ut-robotics/picr22-team-placeholder/(threads)

Thread 10 (2022-10-29):

DRV8243 current limiting

ReikoR, 2022-10-29:
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

To prevent motors from overheating, it is recommended to configure driver output current limit to around 2 - 3A.

When ITRIP is connected to GND the current regulation is disabled.

From datasheet:
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

ITRIP should be configured to some level (leaving the pin unconnected sets ITRIP level to 2.97V) and IPROPI resistor should be connected to set a current limit.

Closed 2022-11-06.

Thread 13 (2022-10-29):

Power solder pads pin naming

ReikoR, 2022-10-29:
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

VIN and GND are not good names for this symbol, especially for motor driver outputs.
It's probably better to create component with single pad without any specific pin name. Having the component contain only one pad allows for more flexible PCB layout.

Closed 2022-11-06.

Thread 2 (2022-10-29):

Reverse voltage protection not needed for USB

ReikoR, 2022-10-29:
Not needed, because USB connector can't be connected incorrectly.

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

Closed 2022-11-06.

Thread 3 (2022-10-29):

Use more input and output capacitance for voltage regulators

ReikoR, 2022-10-29:
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

From [NCP164 datasheet](https://www.onsemi.com/pdf/datasheet/ncp164-d.pdf):
> **Input Decoupling (C<sub>IN</sub>)**
> It is recommended to connect at least 1 uF ceramic X5R or X7R capacitor between IN and GND pin of the device.

> **Output Decoupling (C<sub>OUT</sub>)**
> The device is designed to be stable with standard ceramics capacitors with values of 1 uF or greater.

NCV8730 regulator has the same problem.

Closed 2022-11-06.

Thread 4 (2022-10-29):

Reverse voltage protection MOSFET gate resistor not needed

ReikoR, 2022-10-29:
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

I'm not sure if having resistor there can cause problems, but it is mostly needed to limit current through gate protection diode. Since gate protection diode is not used or not needed (BUK6Y10-30P has gate-source voltage rating [20V] above battery voltage [16.8V]), the resistor can also be omitted.

Closed 2022-11-06.

Thread 5 (2022-10-29):

Missing programmer connector connections

ReikoR, 2022-10-29:
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

NRST and one GND is not connected.

Correct pinout can be found from here:
https://ut-robotics.github.io/picr22-home/basketball_robot_guide/electronics/schematic.html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

artursalumae, 2022-10-30:
Does NRST need to be connected? As I understood reset could also be triggered by SWD commands.

ReikoR, 2022-10-30:
Maybe not then. I wasn't aware of software reset. But do you have a reason not to connect it?

artursalumae, 2022-10-30:
Not really, just didn't want to have extra traces around. So it is not a problem to add it

Closed 2022-11-06.

Thread 7 (2022-10-29):

MCU NRST connected incorrectly

ReikoR, 2022-10-29:
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

NRST needs to be connected to programmer connector and 100nF capacitor. NRST pin has internal pullup.

Refer to "5.3.15 NRST pin characteristics" in the [datasheet](https://www.st.com/resource/en/datasheet/stm32g441kb.pdf).

artursalumae, 2022-10-30:
Can NRST be left disconnected as well?

ReikoR, 2022-10-30:
I think capacitor is needed/recommended.

Closed 2022-11-06.

Thread 9 (2022-10-29):

MCU pin assignment

ReikoR, 2022-10-29:
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

Did you use STM32CubeIDE for creating the pin assignment? Current one does not make too much sense.

Some more information on how to configure timers in STM32CubeIDE is on the firmware page:
https://ut-robotics.github.io/picr22-home/basketball_robot_guide/electronics/firmware.html

Please ask if it's not clear how to do the timer configuration and pin assignment.

artursalumae, 2022-10-30:
Yep agreed, I had a wrong understanding in regards to how timers work in STM32. I will commit the fix soon.

ReikoR, 2022-11-06:
It's would be a bit better to have encoder channel A connected to timer channel 1 for all motors. Right now motor 1 encoder is connected this way, but other encoders are not. Otherwise it would need to be corrected in firmware or software.

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

Closed 2022-11-12.

Thread 16 (2022-11-05):

[Mechanics] Add mounting holes to thrower sides

maidlam, 2022-11-05:
Add holes for mounting the thrower to the chassis.

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

ol4f, 2022-11-06:
done

maidlam, 2022-11-06:
Since these are mounting holes, make them either 2,5 mm diameter or a threaded M3 hole with the Hole feature.
Also add holes to the bottom of the walls.

ol4f, 2022-11-06:
should be already?
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

ol4f, 2022-11-06:
done

Closed 2022-11-07.

Thread 18 (2022-11-05):

[Mechanics] Move front spacer lower

maidlam, 2022-11-05:
Move the front spacer lower.
I believe the direction of the wires is toward the blue region. I'm guessing that the path the wires will take to go into the chassis is also in that direction.
The distance from the motor to the spacer is around 4,5 mm. The wires can be rigid near the motor, so they might not be able to bend to fit between the spacer and motor.

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

ol4f, 2022-11-06:
done

Closed 2022-11-06.

Thread 20 (2022-11-05):

[Mechanics] CAM - 2D Contour issues

maidlam, 2022-11-05:
- Enable "Multiple depths" and set it according to the Passes tab settings here https://ut-robotics.github.io/picr22-home/basketball_robot_guide/mechanics/cam.html#_pocket
- Disable "Ramp" in the Linking tab.
- Change the "Cutting feedrate" to 1000 mm/min. Some other settings might change based on that.

ol4f, 2022-11-06:
might be ok now? didn't find the "cutting feedrate" from anywhere

maidlam, 2022-11-06:
For some reason, a 3 mm drill is now selected as the 2D Contour tool.

The "Cutting feedrate" is in the tool tab
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

Also, disable "Keep Tool Down" in the linking tab - it causes unwanted movements through the material
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

ol4f, 2022-11-06:
should be ok now

Closed 2022-11-07.

Thread 21 (2022-11-06):

Split ground planes

ReikoR, 2022-11-06:
Ground planes should be split below isolators to properly separate the MCU and motor driver sides.

A line can be placed on a plane to split it. The line should be as wide as the gap between isolator sides.
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

MCU side should be LGND net and motor drivers side MGND net.
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

Closed 2022-11-12.

Thread 23 (2022-11-06):

Prefer direct polygon and plane connection for vias and high currents

ReikoR, 2022-11-06:
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

Vias and high current connections should be connected directly. Other signals can have relief connection.

New rules can be created for via connection style:
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

Closed 2022-11-12.

Thread 24 (2022-11-06):

Place decoupling capacitors on the same layer as the component

ReikoR, 2022-11-06:
Placing decoupling capacitors on the same layer allows to have shorter connection to the component. Longer connection has higher inductance, which decreases the usefulness of the capacitor.

Closed 2022-11-12.

Thread 26 (2022-11-12):

Use JLC7628 stackup

ReikoR, 2022-11-12:
Use JLC7628 stackup instead of JLC3313 as it is cheaper.

USB differential pair trace width and spacing needs to be changed.

For example 8 mil (about 0.2 mm) trace space and 10.28 mil (about 0.26 mm) trace width would work:
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

ReikoR, 2022-11-13:
Preferred and max gaps and spacings are not correctly set:
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

Closed 2022-11-13.

Thread 27 (2022-11-12):

Prefer tented vias

ReikoR, 2022-11-12:
Untented vias can cause shorts or soldering problems in some cases.

Simplest way to use tented vias is to create new Solder Mask Expansion rule:
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

Closed 2022-11-13.

Thread 28 (2022-11-12):

DRV8243 ITRIP resistor value

ReikoR, 2022-11-12:
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

3.3k is not a correct value to use for configuration.

From [datasheet](https://ut-robotics.github.io/picr22-home/basketball_robot_guide/electronics/drv8243-q1_datasheet_2021-08.pdf):
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

Closed 2022-11-13.

Thread 30 (2022-11-12):

Place vias close to the components

ReikoR, 2022-11-12:
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

Filling signals layers with copper can be considered a bad practice as it can cause more crosstalk. Or it should at least be done carefully and probably not over the whole board.
Some more info about copper fills and crosstalk: https://youtu.be/y4REmZlE7Jg?t=2415
There are anyway 2 internal layers for connecting the ground.
It would be more useful to route most of the signals on top layer and use bottom layer for 3.3V polygon.

At minimum, the vias should be placed close to the component pads to shorten the connection and to decrease the inductance.

Closed 2022-11-13.

Thread 31 (2022-11-12):

Make +16M trace wider and add more vias

ReikoR, 2022-11-12:
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

1 mm trace at the bottom + 0.5 mm trace at the top layer, might limit the current too much.
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

It would be better to have about 3x 16V vias under each driver.
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

ReikoR, 2022-11-13:
Traces are not continuous:
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

You might want to disable loop and via removal from Interactive Routing properties panel:
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

Closed 2022-11-13.

Thread 33 (2022-11-12):

Fix DRC errors

ReikoR, 2022-11-12:
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

ReikoR, 2022-11-13:
Extra holes inside USB connector slots should also be removed:
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

And USB connector 3D model is not properly placed against the pads:
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

Closed 2022-11-13.

Thread 34 (2022-11-13):

Silkscreen text size

ReikoR, 2022-11-13:
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

JLCPCB recommends:
Minimum text height 40 mil (1.0mm)
https://jlcpcb.com/capabilities/pcb-capabilities

From previous experience 0.8 mm height has also worked, if there is not enough room.

Closed 2022-11-13.

Thread 35 (2022-11-13):

Power MCU side of the isolators from 3.3V

ReikoR, 2022-11-13:
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

It will probably work fine with 5V, since all MCU pins connecting to isolators are outputs and isolator inputs logic high threshold voltage is below MCU voltage.

From isolator [datasheet](https://datasheets.maximintegrated.com/en/ds/MAX14130-MAX14932.pdf):
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

But it makes more sense to power isolator with the same voltage as MCU.

ReikoR, 2022-11-13:
It would be better to avoid chaining power for many components and instead have more separate paths. If the paths are shared, then noise from one component can affect other components on the same path.

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

Closed 2022-11-16.

Thread 38 (2022-11-13):

LED resistors have too low resistance

ReikoR, 2022-11-13:
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

51 Ohms is too little resistance, which results in a too high current through LED.

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
https://ohmslawcalculator.com/led-resistor-calculator

Recommended LED current is about 1 mA or less. About 1 kOhm or more resistance would be good.

Closed 2022-11-16.

Thread 39 (2022-11-13):

Improve silkscreen

ReikoR, 2022-11-13:
1. Motor driver reference designators are on the pads:
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

2. It would be useful to number encoder connectors and motor drivers and label other connectors and pads.

Closed 2022-11-16.

Thread 41 (2022-12-02):

Why have 3 pieces in the motor mount?

Akustav, 2022-12-02:
Why do motor mounts consist of 3 components when one could do the same job?

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

ol4f, 2022-12-03:
Should give better stability. But for convenience I can make the main part bigger and discard the side mounts.

Added drillholes.

Akustav, 2022-12-04:
The previous robot had such a scheme to have sloped wheel angels. You do not have them so there should be no point in adding these additional pieces. Now there are some jointing issues:

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

ol4f, 2022-12-05:
Fixed.

Thread 42 (2022-12-02):

What holds the thrower in?

Akustav, 2022-12-02:
Currently there are no mounting screws for the thrower. This is intentional?

ol4f, 2022-12-03:
My mistake, fixed.

Closed 2022-12-04.

Thread 43 (2022-12-02):

Where does the thrower motor cable run?

Akustav, 2022-12-02:
There is no representation of the thrower motor cables so it is hard to see where they run.

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

ol4f, 2022-12-03:
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
Fixed, added a 10mm diameter hole to the thrower.

Closed 2022-12-04.

Thread 44 (2022-12-02):

No camera FOV cone

Akustav, 2022-12-02:
There is no FOV cone for the camera to judge the cameras position. This would also help to reduce the adjustability need. A fixed camera guarantees that the camera is always pointed exactly how you want.

ol4f, 2022-12-03:
done, going to keep it adjustable just in case

Akustav, 2022-12-04:
Hm, what case do you plan to cover? With adjustability comes missa-djustment. If you cave a good angle, it is more robust to fix it to be sure everything works as expected. This is especially important, if you want to replicate the test robots angle, for example.

Also, the joints are somewhat bugged:
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

Akustav, 2022-12-05:
The mating issue still remains. Can give a wrong impression of the camera placement:
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

ol4f, 2022-12-05:
Should be aligned properly now.

Closed 2022-12-09.

Thread 45 (2022-12-02):

RGB camera and rovbot centers not aligned

Akustav, 2022-12-02:
The two do not line up at the moment.

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

ol4f, 2022-12-03:
https://github.com/ut-robotics/picr22-team-placeholder/issues/44#issuecomment-1336202852_

Closed 2022-12-04.

Thread 46 (2022-12-02):

Switch and power socket holes not up to spec

Akustav, 2022-12-02:
The holes here are not up to spec. Refer to the guide for details.

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

https://ut-robotics.github.io/picr22-home/basketball_robot_guide/mechanics/design.html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

ol4f, 2022-12-03:
fixed

Closed 2022-12-04.

Thread 47 (2022-12-02):

Battery box does not hold batteries

Akustav, 2022-12-02:
Currently the batteries can slide out without any issues:

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

ol4f, 2022-12-03:
fixed

Akustav, 2022-12-04:
How wide are the batteries? If they are over 40.70mm, they can slide out.

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

ol4f, 2022-12-05:
Should be around 50mm. I doubt it will slide, as the test robot also has a similar setup with no issues.

Akustav, 2022-12-05:
I think they are around 43mm. so 40mm should technically be ok.

Closed 2022-12-05.

Thread 49 (2022-12-02):

How is the PC mounted

Akustav, 2022-12-02:
I see no mounting holes for the PC

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

ol4f, 2022-12-03:
added proper screwholes.

Akustav, 2022-12-04:
What do these holes attach to on the computer chassis? I dont remember mounting holes being there

ol4f, 2022-12-05:
I copied the screw placements from the old robot's NUC_plate. And the NUC is currently attached with that plate.

Akustav, 2022-12-05:
I think you want to use these holes for mounting and they do not line up with the current holes you have:

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

ol4f, 2022-12-05:
Found them, fixed. Waiting to save.

Thread 50 (2022-12-02):

Blue lines

Akustav, 2022-12-02:
Why so many blue lines in the main chassis sketch?

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

Also looks awfully like the previous years robot... Especially where the thrower socket fits. Dark grey areas are where the two bottom plates align. Weird...
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

ol4f, 2022-12-03:
Fixed blue lines.
The previous design was very inspirational :)

Akustav, 2022-12-04:
Okay... I will close this task later but FYI you can use the EQUALS constraint to define the circle size of one and then make them all equal. Less clutter on sketches that way:

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
###

Closed 2022-12-05.

Thread 52 (2022-12-04):

No electronics in chassis

Akustav, 2022-12-04:
Consider where the electronics will sit in the chassis

ol4f, 2022-12-04:
We were thinking of putting them in middle of the motors, but drill the holes once we've half-assembled it, for optimal placing regarding wiring.

Akustav, 2022-12-05:
I mean you know the sizes, dont you? Why not let the machine do it. Also the step-up converter is rather large so it needs some consideration when fitting into the chassis

ol4f, 2022-12-05:
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
Added the holes to both sides, so the PCB and step-up could be put on either sides, depending on how the wiring is.

ol4f, 2022-12-05:
If you are wondering what the 4 holes in middle of the motors are, then that is also one possible PCB placement spot. The more choices, the merrier.

Closed 2022-12-07.

Thread 53 (2022-12-05):

Battery blocking flaps can fall into holes

Akustav, 2022-12-05:
The flaps seem too short for the moment:

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

ol4f, 2022-12-05:
Made it longer. Waiting to save.
