ut-robotics/picr22-team-placeholder/(list of files, drawings)

Other design files:
electronics/picr22-team-placeholder-electronics/.PcbLib
electronics/picr22-team-placeholder-electronics/.SchLib
electronics/picr22-team-placeholder-electronics/Board.PcbDoc
electronics/picr22-team-placeholder-electronics/Mainboard.SchDoc
electronics/picr22-team-placeholder-electronics/MicroController.SchDoc
electronics/picr22-team-placeholder-electronics/MotorControl.SchDoc
electronics/picr22-team-placeholder-electronics/picr22-team-placeholder-electronics.PrjPcb
