ut-robotics/picr22-team-placeholder/firmware/PiCR_Firmware/Core/Src/main.c

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
/* Includes ------------------------------------------------------------------*/
#include "main.h"
#include "usb_device.h"

/* USER CODE BEGIN Includes */
#include "usbd_cdc_if.h"
#include "stm32g4xx_hal_tim.h"
/* USER CODE END Includes */

/* USER CODE BEGIN PTD */
typedef struct __attribute__((packed)) Command {
	int16_t speed1;
	int16_t speed2;
	int16_t speed3;
	uint16_t throwerSpeed;
	uint16_t delimiter;
} Command;

typedef struct Feedback {
	int16_t speed1;
	int16_t speed2;
	int16_t speed3;
	uint16_t delimiter;
} Feedback;

typedef struct MotorControl {
	int16_t speed;
	int16_t prevPosition;
	int32_t integral;
	int16_t prevError;
} MotorControl;

// Timer frequency (100 Hz)
// uint8_t periodMs = 10;

uint8_t callCount = 0;

/* USER CODE END PTD */

TIM_HandleTypeDef htim1;
TIM_HandleTypeDef htim2;
TIM_HandleTypeDef htim3;
TIM_HandleTypeDef htim4;
TIM_HandleTypeDef htim6;
TIM_HandleTypeDef htim8;

/* USER CODE BEGIN PV */
Command command = { .speed1 = 0, .speed2 = 0, .speed3 = 0, .throwerSpeed = 0,
		.delimiter = 0 };

volatile uint8_t isCommandReceived = 0;

MotorControl motor1Control = { .speed = 0, .prevPosition = 0, .integral = 0,
		.prevError = 0 };
MotorControl motor2Control = { .speed = 0, .prevPosition = 0, .integral = 0,
		.prevError = 0 };
MotorControl motor3Control = { .speed = 0, .prevPosition = 0, .integral = 0,
		.prevError = 0 };
/* USER CODE END PV */

void SystemClock_Config(void);
static void MX_GPIO_Init(void);
static void MX_TIM1_Init(void);
static void MX_TIM2_Init(void);
static void MX_TIM3_Init(void);
static void MX_TIM4_Init(void);
static void MX_TIM8_Init(void);
static void MX_TIM6_Init(void);
/* USER CODE BEGIN 0 */

int32_t clamp(int32_t value, int32_t min, int32_t max) {
	if (value > max) {
		return max;
	}

	if (value < min) {
		return min;
	}
	return value;
}

void CDC_On_Receive(uint8_t *buffer, uint32_t *length) {
	if (*length == sizeof(Command)) {
		memcpy(&command, buffer, sizeof(Command));

		if (command.delimiter == 0xAAAA) {
			isCommandReceived = 1;
		}
	}
}

int16_t CalculatePID(int16_t motorPosition, MotorControl *motorControl,
		int16_t targetSpeed) {
	float Kp = 3000;
	float Ki = 675;
	float Kd = 0;

	int32_t motorPositionDelta = motorPosition - motorControl->prevPosition;
	motorControl->speed = motorPositionDelta;
	motorControl->prevPosition = motorPosition;

	int32_t motorSpeedError = targetSpeed - motorPositionDelta;

	motorControl->integral += motorSpeedError;

	int32_t motorDerivative = motorControl->prevError - motorSpeedError;

	return motorSpeedError * Kp + motorControl->integral * Ki
			+ motorDerivative * Kd;
}

void HAL_TIM_PeriodElapsedCallback(TIM_HandleTypeDef *htim) {
	int32_t motor1PWM = CalculatePID((int16_t) TIM2->CNT, &motor1Control,
			command.speed1);
	int32_t motor2PWM = CalculatePID((int16_t) TIM3->CNT, &motor2Control,
			command.speed2);
	int32_t motor3PWM = CalculatePID((int16_t) TIM4->CNT, &motor3Control,
			command.speed3);

	HAL_GPIO_WritePin(M1_Dir_GPIO_Port, M1_Dir_Pin,
			(motor1PWM < 0) ? GPIO_PIN_SET : GPIO_PIN_RESET);
	TIM1->CCR1 = (uint16_t) clamp((motor1PWM < 0) ? -motor1PWM : motor1PWM, 0,
			65535);

	HAL_GPIO_WritePin(M2_Dir_GPIO_Port, M2_Dir_Pin,
			(motor2PWM < 0) ? GPIO_PIN_SET : GPIO_PIN_RESET);
	TIM1->CCR2 = (uint16_t) clamp((motor2PWM < 0) ? -motor2PWM : motor2PWM, 0,
			65535);

	HAL_GPIO_WritePin(M3_Dir_GPIO_Port, M3_Dir_Pin,
			(motor3PWM < 0) ? GPIO_PIN_SET : GPIO_PIN_RESET);
	TIM1->CCR3 = (uint16_t) clamp((motor3PWM < 0) ? -motor3PWM : motor3PWM, 0,
			65535);

	callCount++;

	if (callCount >= 50) {
		callCount = 0;

		command.speed1 = 0;
		command.speed2 = 0;
		command.speed3 = 0;

		motor1Control.integral = 0;
		motor2Control.integral = 0;
		motor3Control.integral = 0;

		motor1Control.prevError = 0;
		motor2Control.prevError = 0;
		motor3Control.prevError = 0;

		motor1Control.prevPosition = 0;
		motor2Control.prevPosition = 0;
		motor3Control.prevPosition = 0;

		TIM1->CCR1 = 0;
		TIM1->CCR2 = 0;
		TIM1->CCR3 = 0;
	}
}

int _write(int file, char *ptr, int len) {
	/* Implement your write code here, this is used by puts and printf for example */
	int i = 0;
	for (i = 0; i < len; i++)
		ITM_SendChar((*ptr++));
	return len;
}
/* USER CODE END 0 */

/**
  * @brief  The application entry point.
  * @retval int
  */
int main(void)
{
  /* MCU Configuration--------------------------------------------------------*/

  /* Reset of all peripherals, Initializes the Flash interface and the Systick. */
  HAL_Init();

  /* Configure the system clock */
  SystemClock_Config();

  /* Initialize all configured peripherals */
  MX_GPIO_Init();
  MX_USB_Device_Init();
  MX_TIM1_Init();
  MX_TIM2_Init();
  MX_TIM3_Init();
  MX_TIM4_Init();
  MX_TIM8_Init();
  MX_TIM6_Init();
  /* USER CODE BEGIN 2 */
	Feedback feedback = { .speed1 = 0, .speed2 = 0, .speed3 = 0, .delimiter =
			0xAAAA };

	HAL_TIM_Encoder_Start(&htim2, TIM_CHANNEL_1 | TIM_CHANNEL_2);
	HAL_TIM_Encoder_Start(&htim3, TIM_CHANNEL_1 | TIM_CHANNEL_2);
	HAL_TIM_Encoder_Start(&htim4, TIM_CHANNEL_1 | TIM_CHANNEL_2);

	HAL_TIM_PWM_Start(&htim1, TIM_CHANNEL_1 | TIM_CHANNEL_2 | TIM_CHANNEL_3);

	HAL_GPIO_WritePin(M_Sleep_GPIO_Port, M_Sleep_Pin, GPIO_PIN_SET);

	//HAL_TIM_Base_Start_IT(&htim6);
  /* USER CODE END 2 */

  /* Infinite loop */
  /* USER CODE BEGIN WHILE */
	while (1) {
		//HAL_GPIO_WritePin(LED_GPIO_Port, LED_Pin, GPIO_PIN_SET);
    /* USER CODE END WHILE */

    /* USER CODE BEGIN 3 */
		feedback.speed1 = motor1Control.speed;
		feedback.speed2 = motor2Control.speed;
		feedback.speed3 = motor3Control.speed;

		CDC_Transmit_FS((uint8_t*) &feedback, sizeof(feedback));

		TIM1->CCR1 = 256;
		TIM1->CCR2 = 256;
		TIM1->CCR3 = 256;

		if (isCommandReceived) { // (2)
			isCommandReceived = 0;
			HAL_GPIO_TogglePin(LED_GPIO_Port, LED_Pin);

			feedback.speed1 = motor1Control.speed;
			feedback.speed2 = motor2Control.speed;
			feedback.speed3 = motor3Control.speed;

			CDC_Transmit_FS((uint8_t*) &feedback, sizeof(feedback));
		}
		HAL_Delay(250);
	}
  /* USER CODE END 3 */
}

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
