ut-robotics/picr22-team-placeholder/firmware/PiCR_Firmware/PiCR_Firmware.ioc

Mcu.UserName=STM32G441KBTx
PA0.Signal=S_TIM2_CH1
PA1.Signal=S_TIM2_CH2
PA10.Signal=S_TIM1_CH3
PA11.Signal=USB_DM
PA12.Signal=USB_DP
PA13.Signal=SYS_JTMS-SWDIO
PA14.Signal=SYS_JTCK-SWCLK
PA15.Signal=S_TIM8_CH1
PA2.GPIO_Label=M_Sleep
PA2.Signal=GPIO_Output
PA3.GPIO_Label=M1_Dir
PA3.Signal=GPIO_Output
PA4.Signal=S_TIM3_CH2
PA6.Signal=S_TIM3_CH1
PA8.Signal=S_TIM1_CH1
PA9.Signal=S_TIM1_CH2
PB6.Signal=S_TIM4_CH1
PB7.Signal=S_TIM4_CH2
PB8-BOOT0.GPIO_Label=LED
PB8-BOOT0.Signal=GPIO_Output
PF0-OSC_IN.GPIO_Label=M3_Dir
PF0-OSC_IN.Signal=GPIO_Output
PF1-OSC_OUT.GPIO_Label=M2_Dir
PF1-OSC_OUT.Signal=GPIO_Output
PG10-NRST.GPIO_Label=NRST
PG10-NRST.Signal=GPXTI10
