ut-robotics/picr22-team-placeholder/firmware/PiCR_Firmware/Core/Inc/main.h

#define M3_Dir_Pin GPIO_PIN_0
#define M3_Dir_GPIO_Port GPIOF
#define M2_Dir_Pin GPIO_PIN_1
#define M2_Dir_GPIO_Port GPIOF
#define NRST_Pin GPIO_PIN_10
#define NRST_GPIO_Port GPIOG
#define M_Sleep_Pin GPIO_PIN_2
#define M_Sleep_GPIO_Port GPIOA
#define M1_Dir_Pin GPIO_PIN_3
#define M1_Dir_GPIO_Port GPIOA
#define LED_Pin GPIO_PIN_8
#define LED_GPIO_Port GPIOB
