ut-robotics/picr22-team-placeholder/software/modules/image_processor.py

import _pickle as pickle
import numpy as np
import cv2
import segment
from ..modules.Color import Color
from ..modules.helper_jit import find_pixels_near_ball, np_zeros_jit, get_average_distance
from ..modules.helper import get_colors_pkl_path


class Object():
    def __init__(self, x=-1, y=-1, size=-1, distance=-1, exists=False):
        self.x = x
        self.y = y
        self.size = size
        self.distance = distance
        self.exists = exists

    def __str__(self) -> str:
        return "[Object: x={}; y={}; size={}; distance={}; exists={}]".format(self.x, self.y, self.size, self.distance, self.exists)

    def __repr__(self) -> str:
        return "[Object: x={}; y={}; size={}; distance={}; exists={}]".format(self.x, self.y, self.size, self.distance, self.exists)


# results object of image processing. contains coordinates of objects and frame data used for these results
class ProcessedResults():

    def __init__(self,
                 balls=[],
                 basket_b=Object(exists=False),
                 basket_m=Object(exists=False),
                 color_frame=[],
                 depth_frame=[],
                 fragmented=[],
                 debug_frame=[]) -> None:

        self.balls = balls
        self.basket_b = basket_b
        self.basket_m = basket_m
        self.color_frame = color_frame
        self.depth_frame = depth_frame
        self.fragmented = fragmented

        # can be used to illustrate things in a separate frame buffer
        self.debug_frame = debug_frame


# Main processor class. processes segmented information
class ImageProcessor():
    def __init__(self, camera, logger, config, color_config=get_colors_pkl_path(), debug=False, colors_lookup=None):
        self.camera = camera
        self.logger = logger
        self.debug = debug
        self.config = config
        # distance to stop ignoring balls from
        self.min_basket_distance = self.config["camera"]["min_basket_dist"]

        # -- COLOUR CONFIG --
        self.color_config = color_config
        if colors_lookup is None:
            with open(self.color_config, 'rb') as conf:
                self.colors_lookup = pickle.load(conf)
        else:
            self.colors_lookup = colors_lookup
        self.set_segmentation_table(self.colors_lookup)

        # -- FRAGMENTED --
        self.fragmented = np_zeros_jit(
            self.camera.rgb_height, self.camera.rgb_width)

        # -- OBJECTS --
        self.t_balls = np_zeros_jit(
            self.camera.rgb_height, self.camera.rgb_width)
        self.max_black_count = self.config["camera"]["max_black_count"]
        self.min_white_count = self.config["camera"]["min_white_count"]
        self.t_basket_b = np_zeros_jit(
            self.camera.rgb_height, self.camera.rgb_width)
        self.t_basket_m = np_zeros_jit(
            self.camera.rgb_height, self.camera.rgb_width)
        # moving average for baskets
        self.avg_history = self.config["camera"]["avg_history"]

        # -- DEBUG FRAME --
        self.debug_frame = np_zeros_jit(
            self.camera.rgb_height, self.camera.rgb_width)
        self.basket_distances = list()

        # -- KERNELS --
        self.ball_kernel = cv2.getStructuringElement(cv2.MORPH_ELLIPSE, (5, 5))
        self.basket_kernel = np.ones((3, 3), np.uint8)

    def set_segmentation_table(self, table):
        segment.set_table(table)

    def start(self):
        self.camera.open()

    def stop(self):
        self.camera.close()

    def analyze_balls(self, t_balls, depth, fragments, basket) -> list:
        t_balls = cv2.morphologyEx(t_balls, cv2.MORPH_OPEN, self.ball_kernel)
        contours, _ = cv2.findContours(
            t_balls, cv2.RETR_EXTERNAL, cv2.CHAIN_APPROX_SIMPLE)
        balls = []
        frag_x, frag_y = np.shape(fragments)
        for contour in contours:
            size = cv2.contourArea(contour)

            if size < 15:
                continue

            x, y, w, h = cv2.boundingRect(contour)
            black_count, white_count, dimensions = find_pixels_near_ball(
                fragments, (x, y, w, h), (frag_x, frag_y), 50)
            if black_count > self.max_black_count:  # skip the ball if its on the black part of the arena. this is not as good as line detection but good enough for now
                if white_count < self.min_white_count:
                    continue

            ys = np.array(
                np.arange(y + h, self.camera.rgb_height), dtype=np.uint16)
            xs = np.array(np.linspace(
                x + w/2, self.camera.rgb_width / 2, num=len(ys)), dtype=np.uint16)

            obj_x = int(x + (w/2))
            obj_y = int(y + (h/2))
            if depth is None:
                obj_dst = obj_y
            else:
                try:
                    obj_dst = np.mean(depth[obj_y-1:obj_y+1, obj_x-1:obj_x+1])
                except (ZeroDivisionError):
                    self.logger.log.error(
                        "Ball attempted to divide by zero when averaging.")
                    continue

            if self.debug:
                self.debug_frame[ys, xs] = [0, 0, 0]
                cv2.circle(self.debug_frame, (obj_x, obj_y),
                           10, (0, 255, 0), 2)
                cv2.rectangle(self.debug_frame, (dimensions[0], dimensions[1]), (
                    dimensions[2], dimensions[3]), (0, 255, 0), 3)

            balls.append(Object(x=obj_x, y=obj_y, size=size,
                         distance=obj_dst, exists=True))

        balls.sort(key=lambda x: x.distance)

        return balls

    def analyze_baskets(self, t_basket, depth, fragments, color_id,  debug_color=(0, 255, 255)) -> list:
        t_basket = cv2.morphologyEx(
            t_basket, cv2.MORPH_CLOSE, self.basket_kernel)
        contours, _ = cv2.findContours(
            t_basket, cv2.RETR_EXTERNAL, cv2.CHAIN_APPROX_SIMPLE)
        baskets = []

        for contour in contours:
            size = cv2.contourArea(contour)

            if size < 100:
                continue

            x, y, w, h = cv2.boundingRect(contour)

            obj_x = int(x + (w/2))
            obj_y = int(y + (h/4))
            if depth is None:
                obj_dst = obj_y
            else:
                try:
                    y1 = max(obj_y - 10, y)
                    y2 = min(obj_y + 10, y + h)
                    x1 = max(obj_x - 10, x)
                    x2 = min(obj_x + 10, x + w)
                    obj_dst = get_average_distance(
                        fragments[y1:y2, x1:x2], depth[y1:y2, x1:x2], color_id)
                except (ZeroDivisionError):
                    self.logger.log.error(
                        "Basket attempted to divide by zero when averaging.")
                    continue
            self.basket_distances.append(obj_dst)
            if len(self.basket_distances) > self.avg_history:
                self.basket_distances.pop(0)  # remove oldest item
            obj_dst = np.mean(self.basket_distances)
            baskets.append(Object(x=obj_x, y=obj_y, size=size,
                           distance=obj_dst, exists=True))

        baskets.sort(key=lambda x: x.size)

        basket = next(iter(baskets), Object(exists=False))

        if self.debug:
            if basket.exists:
                cv2.circle(self.debug_frame, (basket.x, basket.y),
                           5, debug_color, -1)

        return basket

    def get_frame_data(self, aligned_depth=False):
        if self.camera.has_depth_capability():
            return self.camera.get_frames(aligned=aligned_depth)
        else:
            return self.camera.get_color_frame(), np.zeros((self.camera.rgb_height, self.camera.rgb_width), dtype=np.uint8)

    def process_frame(self, aligned_depth=False) -> ProcessedResults:
        color_frame, depth_frame = self.get_frame_data(
            aligned_depth=aligned_depth)

        segment.segment(color_frame, self.fragmented,
                        self.t_balls, self.t_basket_m, self.t_basket_b)

        if self.debug:
            self.debug_frame = np.copy(color_frame)
        basket_b = self.analyze_baskets(
            self.t_basket_b, depth_frame, self.fragmented, 3, debug_color=Color.BLUE.color.tolist())
        basket_m = self.analyze_baskets(
            self.t_basket_m, depth_frame, self.fragmented, 2, debug_color=Color.MAGENTA.color.tolist())
        if basket_b.exists and basket_m.exists:
            basket_to_check = basket_b if basket_b.distance > basket_m.distance else basket_m
        elif True in [basket_b.exists, basket_m.exists]:
            basket_to_check = basket_b if basket_b.exists else basket_m
        else:
            basket_to_check = None

        balls = self.analyze_balls(
            self.t_balls, depth_frame, self.fragmented, basket_to_check)

        return ProcessedResults(balls=balls,
                                basket_b=basket_b,
                                basket_m=basket_m,
                                color_frame=color_frame,
                                depth_frame=depth_frame,
                                fragmented=self.fragmented,
                                debug_frame=self.debug_frame)
