ut-robotics/picr22-team-placeholder/(commit log)

2022-09-08 add basic servo speed code
2022-09-08 read and print response from mainboard
2022-09-12 switched to while loop, added a delay
2022-10-13 update wheel distance
2022-10-14 add bootcamp camera code as a base
2022-10-15 Imported all of the required libraries
    [Mainboard.SchDoc, MotorControl.SchDoc, MotorDriver.SchDoc, picr22-team-placeholder-electronics.PrjPcb]
2022-10-17 Added extra libraries and connected a bunch of components
    [Mainboard.SchDoc]
2022-10-17 Added a bunch of connections
    [Mainboard.SchDoc, MotorControl.SchDoc, MotorDriver.SchDoc]
2022-10-18 (no) more wheel
2022-10-18 switch to analog inputs for DS4, add thrower
    also some cleanup in general
2022-10-23 Finished the backbone of the schematic, still need to do some error checking and small improvements
    [Mainboard.SchDoc, MotorControl.SchDoc, MotorDriver.SchDoc, picr22-team-placeholder-electronics.PrjPcb]
2022-10-24 Added switching voltage regulator to thrower power, fixed DRC errors and warnings, made stuff prettier
    [.PcbLib, .SchLib, Mainboard.SchDoc, MotorControl.SchDoc, MotorDriver.SchDoc]
2022-10-30 Implemented changes mentioned in review
    [Mainboard.SchDoc, MotorControl.SchDoc]
2022-11-03 cleanup, attempted fixes, maybe i broke it even more
    [ds4_control.py, motion.py]
2022-11-03 fix for new wheel angles
    [ds4_control.py, motion.py]
2022-11-04 Fixed schematic, placed all the motor control side components
    [Board.PcbDoc, Mainboard.SchDoc, MotorControl.SchDoc, picr22-team-placeholder-electronics.PrjPcb]
2022-11-05 disable some logging and fix ball find
    [motion.py]
2022-11-05 PCB V1 ready I guess
    [Board.PcbDoc, Mainboard.SchDoc]
2022-11-05 Fixed some Design Rule Check errors
    [Board.PcbDoc, picr22-team-placeholder-electronics.PrjPcb]
2022-11-06 Moved MicroController.SchDoc back to source folder
    [Board.PcbDoc, MicroController.SchDoc, picr22-team-placeholder-electronics.PrjPcb]
2022-11-07 Changed passive component footprints, moved decoupling capacitors to the same layer
    [Board.PcbDoc, Mainboard.SchDoc, MicroController.SchDoc, MotorControl.SchDoc, picr22-team-placeholder-electronics.PrjPcb]
2022-11-07 Funked up the board shape
    [Board.PcbDoc]
2022-11-08 rebind X axis, improve thrower behaviour
2022-11-08 Fixed DRC-s, fixed issues, wired all the stuff, rewired all the stuff
    [Board.PcbDoc, Mainboard.SchDoc, MicroController.SchDoc, MotorControl.SchDoc]
2022-11-08 Removed weird vias and added motor net class to schematic to have a specific polygon direct connection rule for motor pads
    [Board.PcbDoc, MotorControl.SchDoc]
2022-11-09 disabled wait, fixes and QoL for DS4
    [ds4_control.py]
2022-11-10 basket toggle button, ensured that RC funcs cant be used outside RC
2022-11-12 Fixed issues
    [Board.PcbDoc, MotorControl.SchDoc]
2022-11-13 Fixed issues and added gerbers
    [Board.PcbDoc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]
2022-11-13 Moved encoders and texts around to be more logical
    [Board.PcbDoc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]
2022-11-14 Not sure what changed but will commit just in case
    [picr22-team-placeholder-electronics.PrjPcb]
2022-11-17 some small fixes and todos
    [image_processor.py, referee.py]
2022-11-19 switched to mp for referee, cleanup
2022-11-21 some todos and prints
2022-11-22 basic black avoidance,basket escape state
    [helper_jit.py, image_processor.py, states.py]
2022-11-24 ds4 fixes, disable fps counter
    [ds4_control.py]
2022-11-24 thrower calibration + bugfix
    [helper.py]
2022-11-24 calibrate thrower some more
2022-12-05 current config
2022-12-06 fixes to ball detection and cleanup
    [helper_jit.py, image_processor.py]
2022-12-07 a hole
2022-12-08 cut down on log spam
2022-12-14 did stuff
    [picr22-team-placeholder-electronics.PrjPcb]
2022-12-17 compatibility fix for new bot
    [motion.py]
2023-01-16 switch dpad order
2023-01-18 Added BOM
    [placeholder-bom.tsv]
2023-01-21 Added more information to documentation and added board picture
2023-01-21 Updated BOM
    [placeholder-bom.tsv]
2023-01-22 add board connectors to media folder
