ut-robotics/picr22-team-placeholder/(notices)

Notices in the files:
firmware/PiCR_Firmware/Core/Inc/main.h:
Copyright (c) 2022 STMicroelectronics.
All rights reserved.
This software is licensed under terms that can be found in the LICENSE file
